LoicBertin/PEIP2BriceLoic/README.md

Polytech

Ce projet est réalisé dans le cadre de la formation de prépa intégrée de Polytech'Nice Sophia

Projet Bipède Peip2
===================

Descriptif du projet
--------------------

Le projet est de réaliser un bipède, muni de fonction motrice sommaire lui permettant d'avancer et de tourner mais aussi un bras articulé lui permettant d'attraper un objet devant lui et de maintenir un équilibre malgré l'objet soulevé.

Ordre de développement
----------------------

1) La marche avant et arrière
2) Pouvoir tourner
3) Rajouter un tronc ainsi que la pince

Materiel utilisé
----------------
