LoicBertin/PEIP2BriceLoic/doc/ArduinoPDF.pdf

# Robot bipède arduino

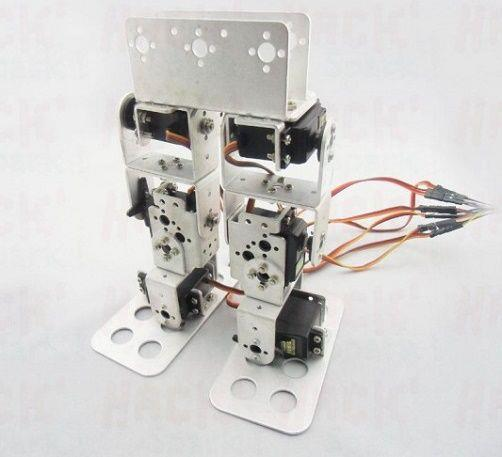
[picture p1: figure]

BERTIN Loïc
GRAULIER Brice

## Sommaire

### - Problématique et motivations - Objectifs - Fonctionnalités - Matériel utilisé - Premier planning - Conclusion

## Problématique

### Comment concevoir un robot capable de tenir en équilibre ainsi que ce déplacer sur uniquement deux appuis?

## Motivation & Objectifs

Motivations:
- Défis
- La robotique est un thème attirant
- Thème moderne avec les évolutions actuelles

Objectifs:
- Marche droite
- Virage
- Contrôle par bluetooth
- (Rajouter une pince pour attraper des objets)

## Fonctions + Schémas

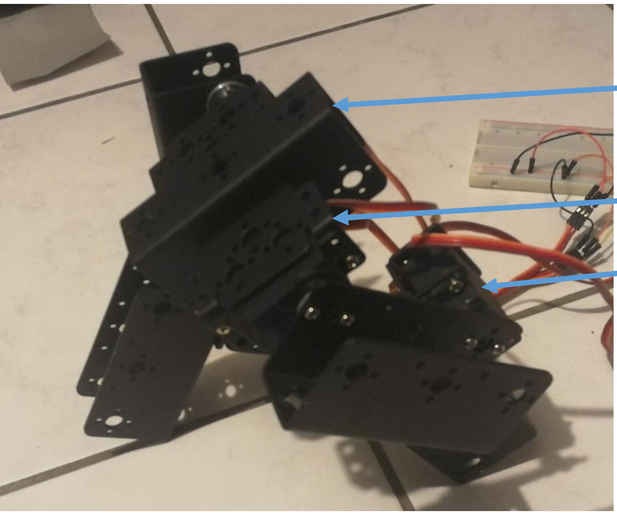
[picture p2: figure]
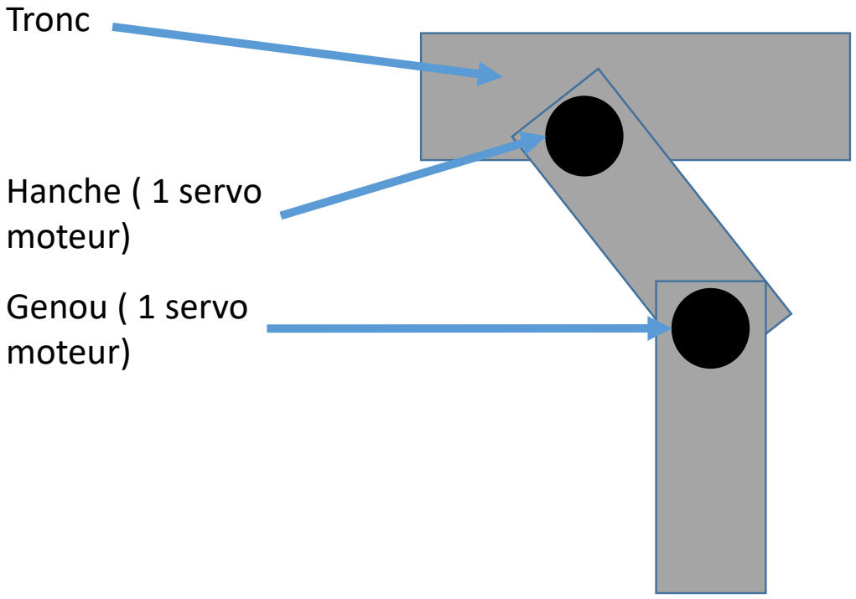
[picture p3: figure]
Genou ( 1 servo moteur); Hanche ( 1 servo moteur); Tronc

## Matériel

Actuel:
- 4 servo-moteurs
- Morceau de métal nécessaire au corps du robot

Futur:
- Une pince donc 1 servo-moteurs de plus
- Le module bluetooth
- ( module ultrason )

## Utilisation du materiel

Actuel:
- Servo moteurs: Servent à l’équilibre + déplacement

Futur:
- La pince: Permettre d’attraper un objet devant le robot
- Le module bluetooth pour contrôler le robot à distance
- (module ultrason : ne pas se prendre de mur)

## Planning

Février: Stabilité du robot et marche

Mars : Rotation du robot

2 premières semaines d’avril : Ajout du bluetooth

Fin avril + mai : Ajout de la pince (et/ou ajout du module de distance)

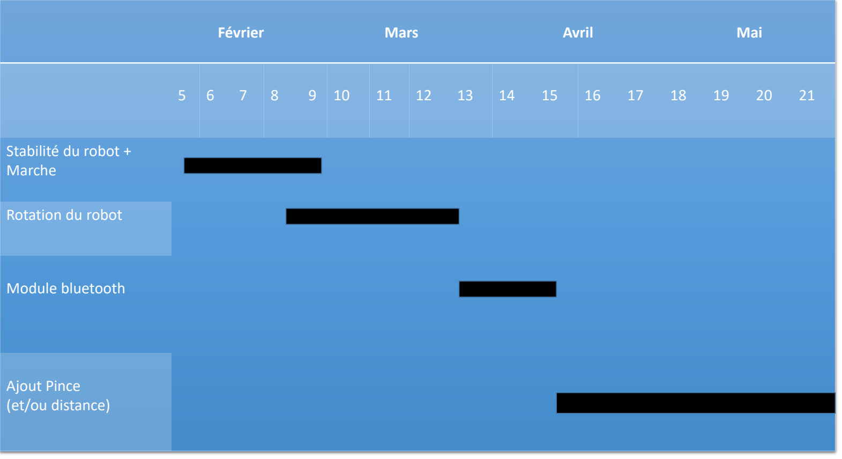
[picture p4: page 9]

Février | Mars | Avril | Mai
| 5 | 6 | 7 | 8 | 9 | 10 | 11 | 12 | 13 | 14 | 15 | 16 | 17 | 18 | 19 | 20 | 21

Stabilité du robot +
Marche

Rotation du robot

Module bluetooth

Ajout Pince
(et/ou distance)

## Conclusion

## - Beaucoup de travail

- Expérience formatrice.
