LoicBertin/PEIP2BriceLoic/doc/LoïcBERTIN.md

Cahier de route de Loïc BERTIN
==============================

* Séance du 18 décembre 2017

Nous avons choisi de réaliser un humanoïde, en premier lieu la partie des jambes et de l'équilibre lors de la marche.
Si cet objectif est réalisé dans les temps, nous aimerions ajouter des bras et de ce fait, réajuster l'équilibre du robot.
Brice s'occupera du mouvement pour avancer et je m'occuperai de l'équilibre à chaque instant du déplacement.
Pour cette séance-ci, nous avons fait quelques expériences avec les servo-moteurs liés au potentiomètre puis avec le module bluetooth à mon 
téléphone. Grâce à des sliders, nous avons contrôlé l'angle des servo-moteurs.

* Séance du 8 janvier 2018

Aujourd'hui nous avons défini le nombre de servo-moteurs nécessaires pour les jambes de notre robot.

image robot

J'ai également décortiqué les pièces déjà présentes dans la salle afin de les réassembler en quelque chose de plus cohérent pour notre projet. Il semblerait que nous possédons déjà les bases des jambes, cependant il manque les pieds.

* Séance du 15 janvier 2018

Aujourd'hui nous avons repensé le design du bipède afin de faciliter son déplacement.Nous avons également commencer à voir le code Arduino pour la marche simple. J'ai ensuite ramené le robot chez moi et j'ai fini le montage.

* Séance du 22 janvier 2018

Après la présentation orale, nous avons bien avancer la marche droite de notre robot, il a réussi à se déplacer sur une trentaine de centimètre avant de chuter.

* Séance du 7 février 2018

Aujourd'hui séance qui a fait énormément avancer le projet. Le robot sait avancer sans chuter, tourner à droite et à gauche.
Nous avons également déplacé la plaque ainsi que la carte sur le dessus du robot pour ne pas qu'il soit géné durant la marche.
Ensuite, nous avons ajouté le module Bluetooth pour qu'il soit controlé depuis le téléphone.

* Séance du 21 février 2018

En rebranchant le robot, il a eu un comportement très particulier dû probablement à des faux-contacts ce qui nous a obligé a tout débrancher puis tout rebrancher sans le bluetooth afin de refaire les calibrages des positions de départ.
Nous avons réinitialisé une nouvelle position de départ afin d'être plus stable.

* Séance du 21 mars 2018

Le robot fonctionne à nouveau comme avant sans le module bluetooth. Nous lui avons ajouté des "semmelles" afin qu'il ai une meilleure adhérence au sol et qu'il ne glisse pas sur le sol lorsqu'il tente de faire un pas.

* Séance du 28 mars 2018

Sur cette séance, nous avons fait les présentations orales puis nous avons travaillé un peu sur le robot. Nous avons ajouté des poids sur un côté pour voir la réaction du robot et nous remarquons qu'il se soulève légèrement de ce côté là ce qui permet de déplacer l'autre jambe librement sans qu'elle n'accroche au sol.

* Séance du 5 avril 2018

Aujourd'hui nous avons refixé les semelles du robot et nous avons commencer la mise en place du système de contrepoids pour lever déplacer le centre des masses sur sa jambe droite ou gauche
