LoicBertin/PEIP2BriceLoic/doc/BriceGRAULIER.md

Cahier de suivi de Graulier Brice
=================================

• Séance du 8 Janvier
----------------------

Etablie les moteurs pour hanche (droite/gauche) et genoux (droite gauche). Assemblage de premieres jambes et utilisations premieres.
Il ne marche pas encore. Il glisse et n'accroche pas avec ses pieds. Glisse sur place mais ne tombe pas.

• Séance du 15 Janvier
-----------------------

Redesign des jambes. Equilibrage du centre de gravité (symétrie qui permet de mieux controler les jambes). Décortiqué un mouvement de jambe et d'autres test. Mon binome me quite tôt donc je fait des recherche et inspirations sur d'autres modèles préexistants.

Ajouts possible: 
 * Caoutchouc sous les pieds pour une meilleure adhérance. 
 * rotule pour la liaisons pied/jambe pour toujours un appuis plat
 
 • Séance du 22 Janvier
 -----------------------

Présentation se déroule bien (je trouve). On attaque la premiere vrai marche.
Tentative de developer le mouvement sur une jambe. Il avance mais tourne.
Deux jambes successive align le deplacement. 
IL MARCHE!!

• Séance du 7 Février
---------------------

Première fonction de virage (droite et gauche). Le moteur pour la gauche (hanche ou genou pas sûr) semble moins puissant que celui de droite, le robot vire en avançant normalement tout droit. Module BlueTooth incorporé, on peut controlé son avancement!

• Séance du 21 Février
----------------------

Faux contactes. Roblo dérégler. On retravail les branchement et changes les fils qui semblent avoir créé le problème.

• Séance du 21 Mars
-------------------

Réglages des moteurs (jambe droite plus puissante). Ajout de "semmelles" adhésives pour aider au déplacement. Fonction marche copense la dérive à cause des puissances de moteurs differents. Le robot avance plus loin avec de plus petit pas! 

Revu les fonctions de pas droit et gauche semble donner un meilleur équilibre. Jamais tombé depuis le changement.

• Séance du 28 Mars
-------------------

Présentation de l'avencement. On reste dans les temps. Annulation de la construction de bras. Chercher a mettre un poids d'équilibrage pour améliorer la levé de jambe et la démarche. 

• Séance du 5 Avril
-------------------

Monté le support tige poids sur le robot. Réadésion des semelles. On va percé la tige durant le week-end pour y fixer des poids
